danielpops/wook-lightbox/docs/back.png

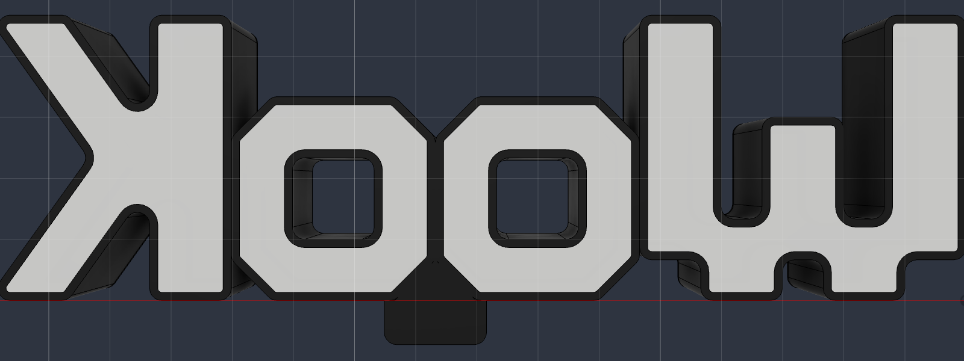
docs/back.png
