danielpops/wook-lightbox/docs/iso.png

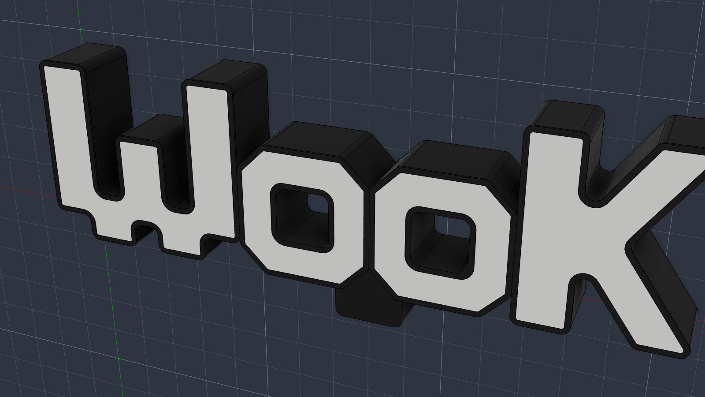
docs/iso.png
