danielpops/wook-lightbox/cad/Wook_Lightbox.step

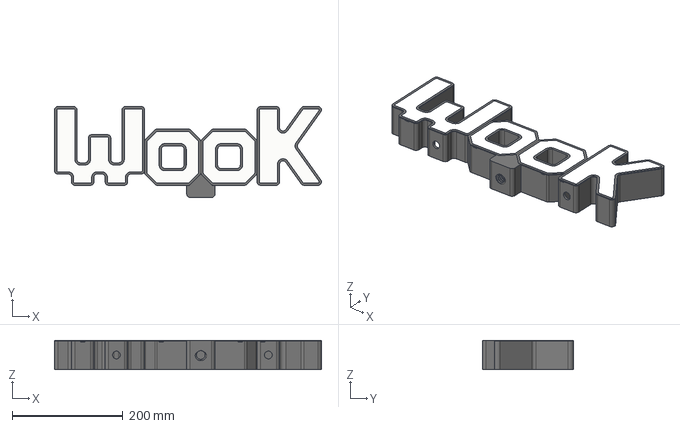
[picture p7: CAD file, 2026-11-11]
cad/Wook_Lightbox.step
482.5 x 164.4 x 52.9 mm
Front
