danielpops/wook-lightbox/(list of files, cad)

Other CAD files:
print/Wook_Lightbox_19in.3mf
cad/Wook_Lightbox.f3d
