danielpops/wook-lightbox/(commit log)

2026-11-05 Wook lightbox: 19" two-sided LED totem sign
    Fusion build script, Bambu-ready 3MF (6 objects), f3d + STEP,
    3MF regroup tool, renders and reference photos, and a README
    covering the design, assembly, printing and how to rebuild.
    [Wook_Lightbox.f3d, Wook_Lightbox.step, Wook_Lightbox_19in.3mf]
2026-11-05 Make cap skirts black so only the faces use translucent filament
    The skirt is hidden behind the black wall, so its color doesn't show.
    With only the 1.5 mm faces in translucent, a low max volumetric speed
    on that filament preset slows just the visible layers, no modifiers.
    [Wook_Lightbox.f3d, Wook_Lightbox.step, Wook_Lightbox_19in.3mf]
2026-11-06 Loosen dovetail clearance to 0.4 mm per side
    0.2 mm was too tight to assemble on the first print.
    [Wook_Lightbox.f3d, Wook_Lightbox.step, Wook_Lightbox_19in.3mf]
2026-11-11 Add 0.4 mm print clearance to the pole thread
    Exact-spec 3/4"-5 ACME wouldn't let a broom handle start. The flanks,
    root and crest are offset outward by the new pole_thread_clear parameter.
    [Wook_Lightbox.f3d, Wook_Lightbox.step, Wook_Lightbox_19in.3mf]
2026-11-11 README: 0.4 mm pole thread clearance confirmed by test print
